Atkelar/XMasOrnament/MakingOf/IMG_20161218_160939.jpg

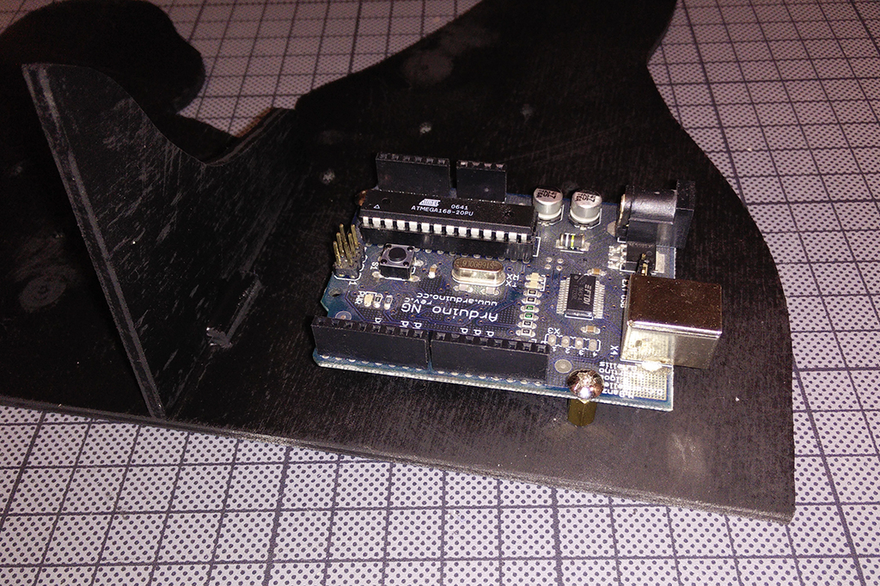
MakingOf/IMG_20161218_160939.jpg
