Atkelar/XMasOrnament/MakingOf/IMG_20161218_172324.jpg

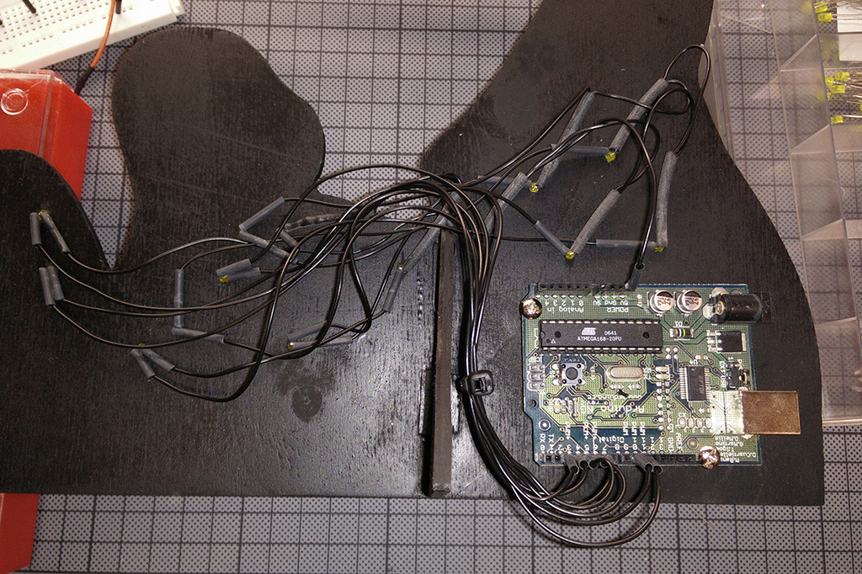
MakingOf/IMG_20161218_172324.jpg
