Atkelar/XMasOrnament/Artwork/CutoutTemplate-1.pdf

## Arduino (NG)

mount on the back.

## Drill for spacer

## threads or screws

Stand

back of the base board.

Glue this end to the

Base board: Cut at outlines, sand and drill the
marked holes for your LEDs (3mm or 5mm)

Glue the stand in this area on the back,

make sure that the lower edges are flush.
