Atkelar/XMasOrnament/Artwork/CutoutTemplate-2.pdf

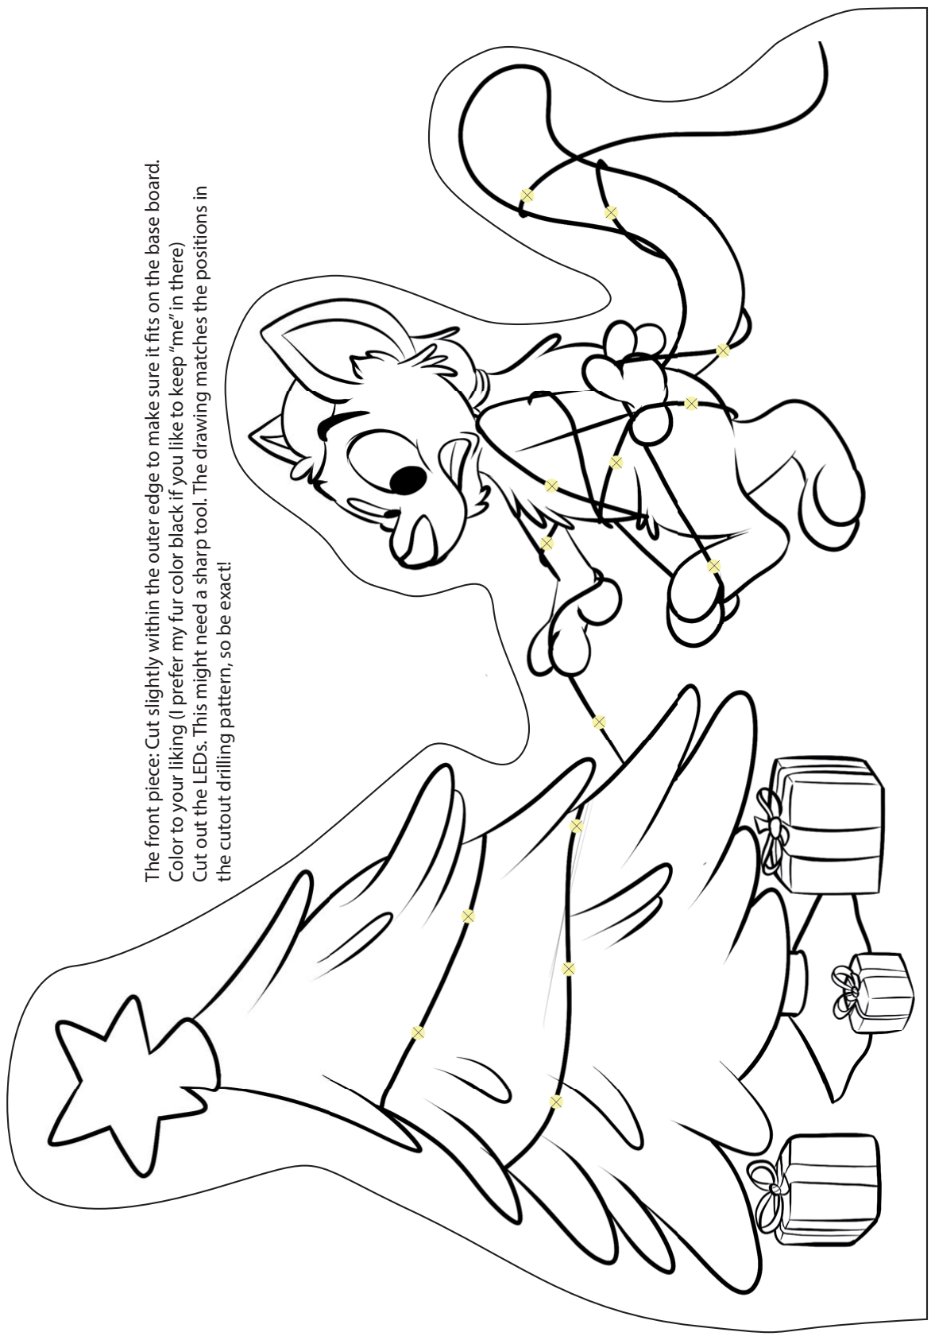
[picture p3: page 1]

The front piece: Cut slightly within the outer edge to make sure it fits on the base board.

Color to your liking (I prefer my fur color black if you like to keep “me” in there)

Cut out the LEDs. This might need a sharp tool. The drawing matches the positions in

the cutout drilling pattern, so be exact!
