Atkelar/XMasOrnament/Schematic.pdf

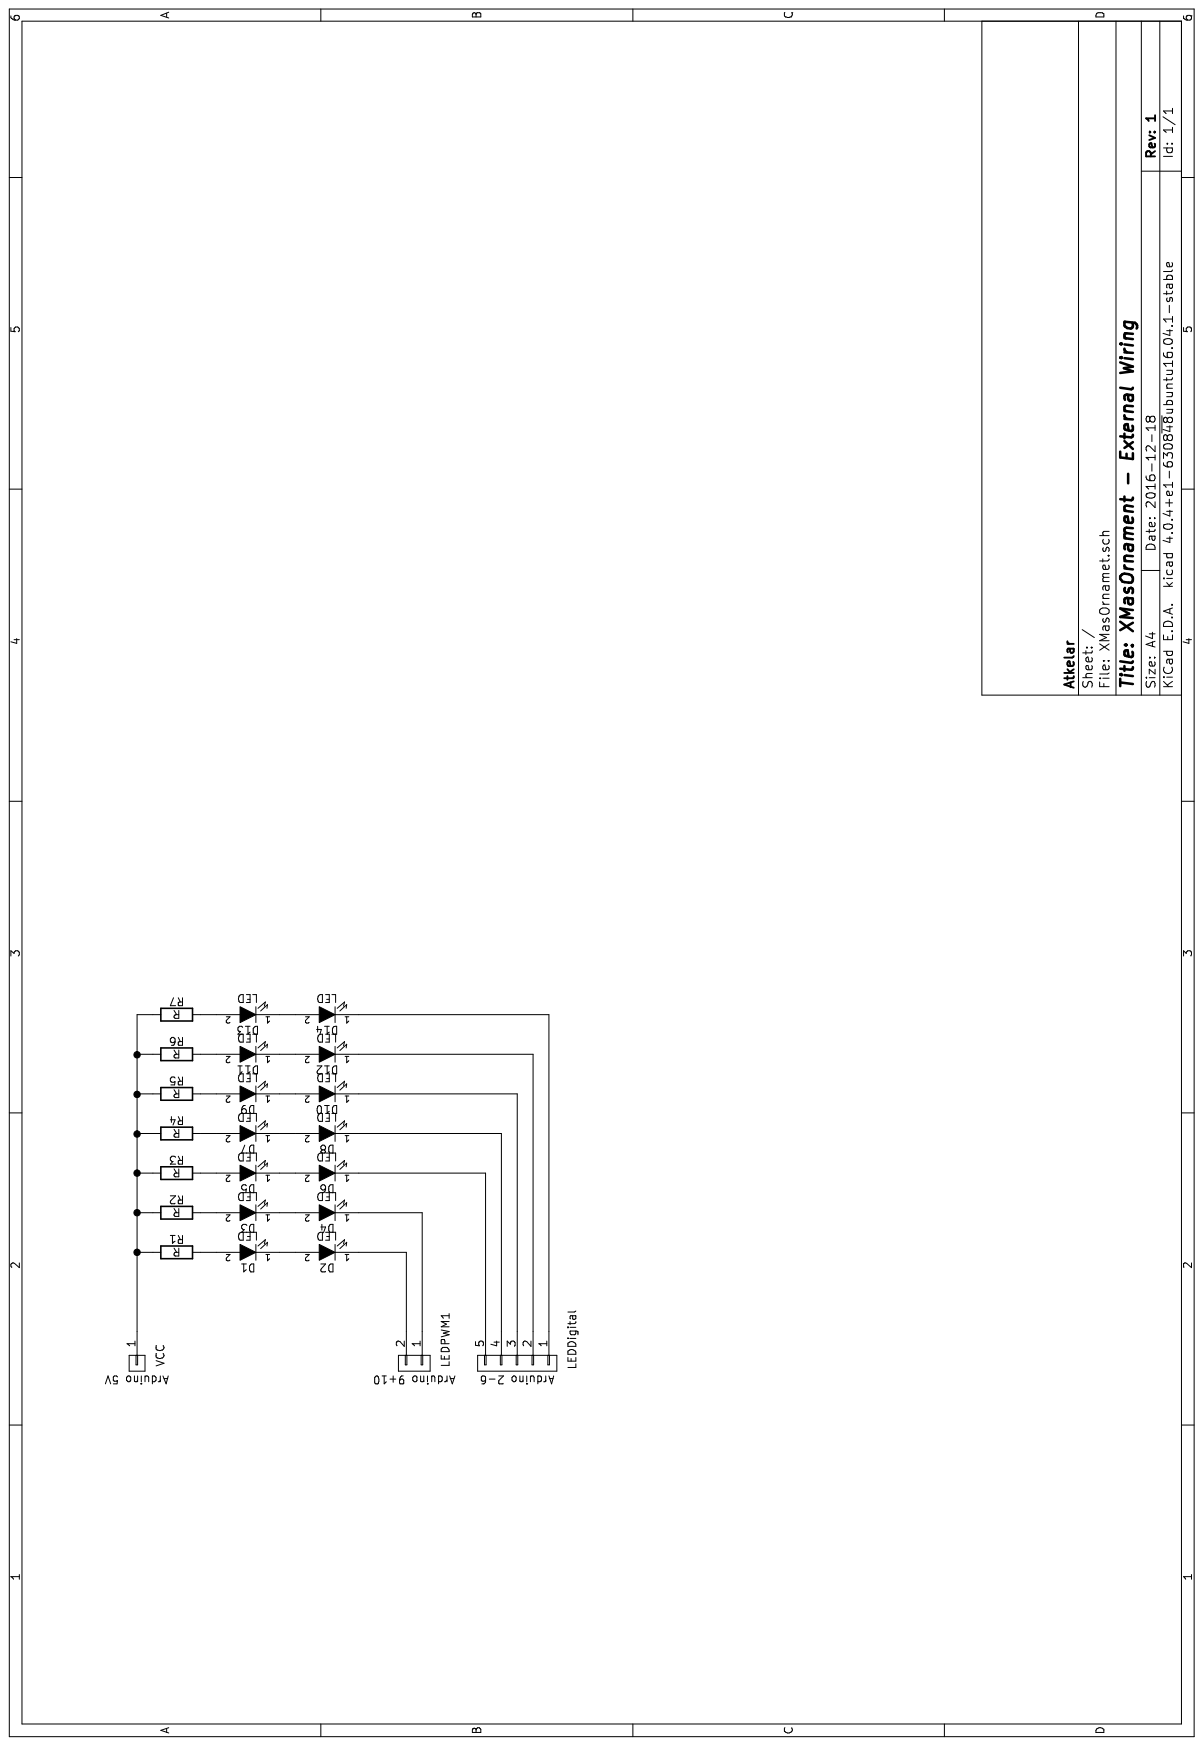
[picture p4: page 1]
