Atkelar/XMasOrnament/MakingOf/IMG_20161218_144124.jpg

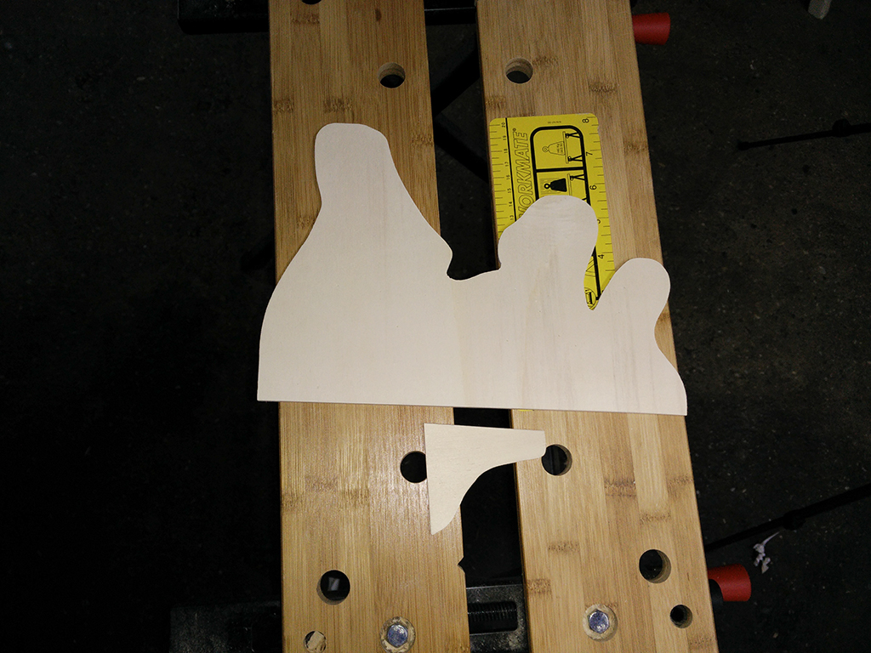
MakingOf/IMG_20161218_144124.jpg
