Atkelar/XMasOrnament/MakingOf/IMG_20161218_160345.jpg

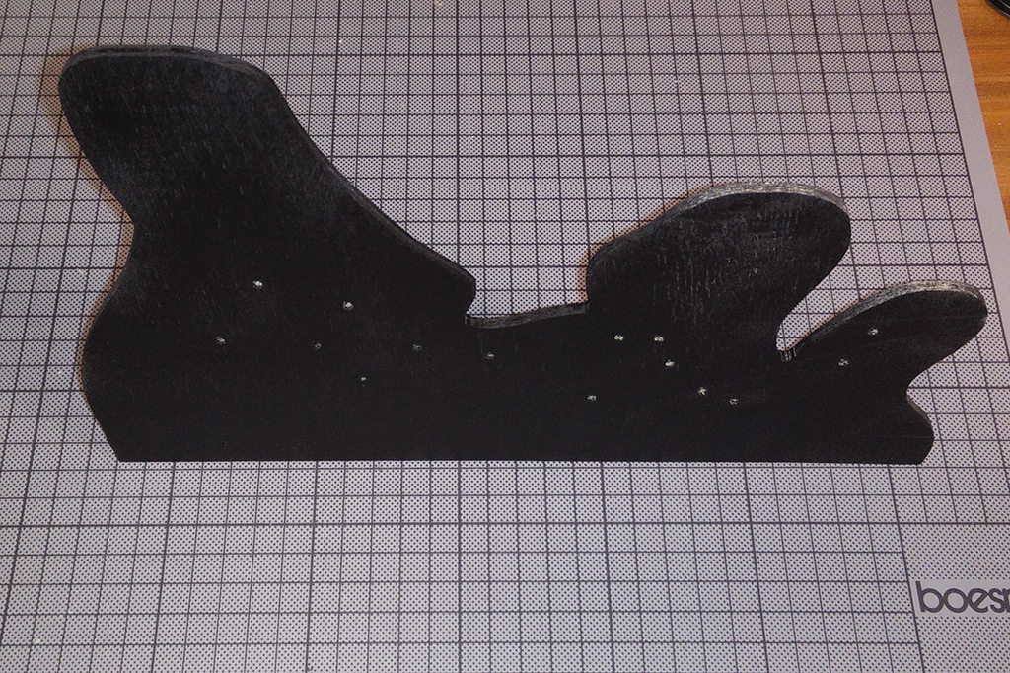
MakingOf/IMG_20161218_160345.jpg
