Atkelar/XMasOrnament/MakingOf/IMG_20161218_160358.jpg

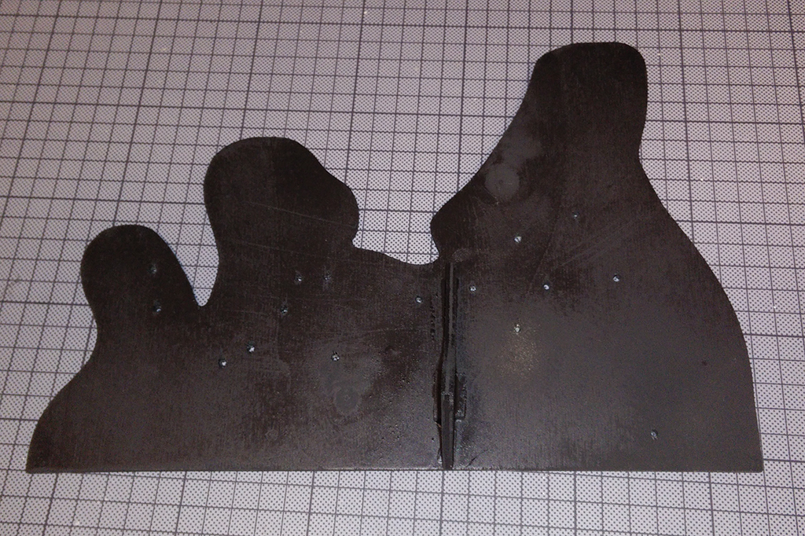
MakingOf/IMG_20161218_160358.jpg
