Atkelar/XMasOrnament/MakingOf/IMG_20161218_160459.jpg

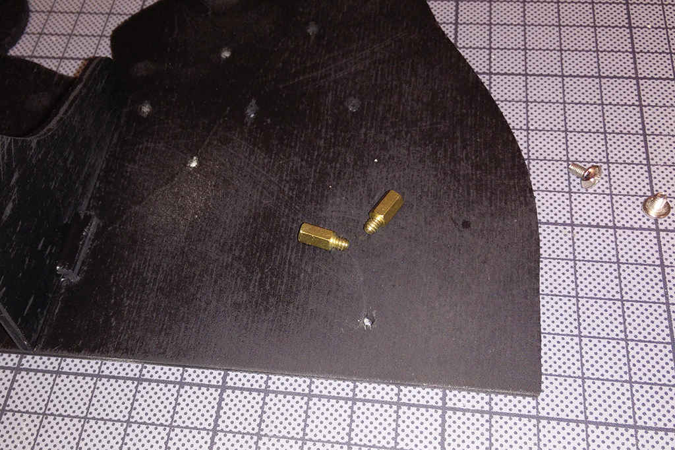
MakingOf/IMG_20161218_160459.jpg
