Atkelar/XMasOrnament/MakingOf/IMG_20161218_162143.jpg

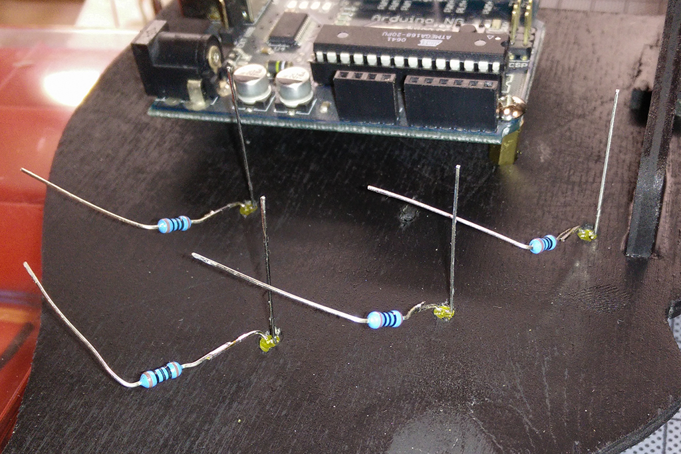
MakingOf/IMG_20161218_162143.jpg
