Atkelar/XMasOrnament/MakingOf/IMG_20161218_164948.jpg

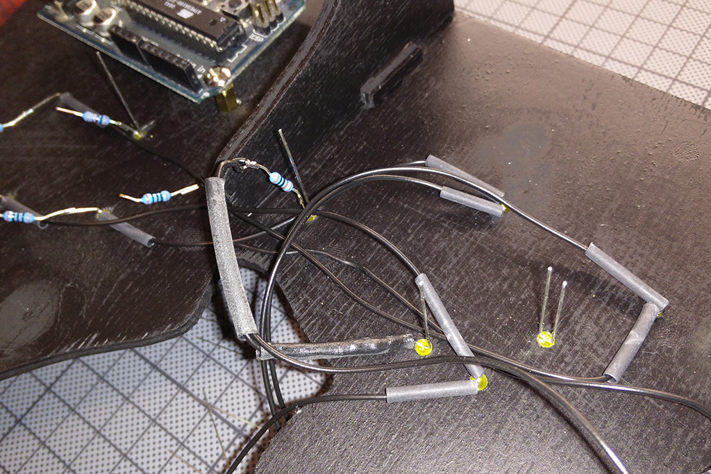
MakingOf/IMG_20161218_164948.jpg
