Atkelar/XMasOrnament/MakingOf/IMG_20161218_210559.jpg

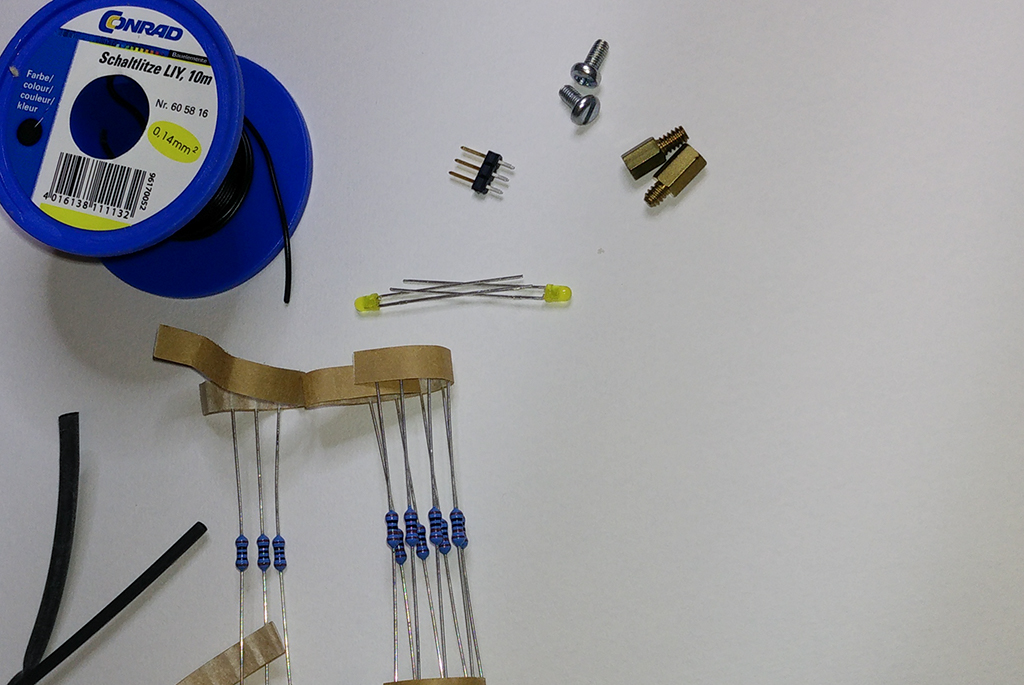
MakingOf/IMG_20161218_210559.jpg
