Atkelar/XMasOrnament/Software/AtkelarXMas.ino

/*

  Atkelar's Christmas Entanglement

  Copyright 2016 by Atkelar

  License: Apache License, Version 2.0

*/

#include "avr/pgmspace.h"
// We need a tad bit more space for the blink-pattern table so 
// we use the program space library and read back the data on-the-go.

// The LED port defaults are: 9 and 10 for PWM output, 2 to 6 for digital.
// The defaults keep pin 0 and 1 free to have 
// debugging TX/RX available if needed.

#define ledPWM1 9
#define ledPWM2 10

#define led0 2
#define led1 3
#define led2 4
#define led3 5
#define led4 6

// The number of steps in the array. Could be calculated by length-of-data / 8.
#define STEPS 165

// The actual light info. To keep the loop simple, we use one byte per pin
// Version 2 would benefit from a structure with bits for digital outputs
// compressed into bit pattern. That way we could *maybe* get away without
// the progmem library. But the pattern generator would be more complicated.
// Pattern data is: 5 digital ports followed by 2 analog ports followed by
// the delay value. The actual loop delay might be slightly larger because
// of all the reading/writing overhead but should be neglectable in MHz clocks.
const byte data[] PROGMEM = {
  LOW, HIGH, HIGH, HIGH, HIGH, 191, 102, 10,
  LOW, HIGH, HIGH, HIGH, HIGH, 179, 102, 10,
  LOW, HIGH, HIGH, HIGH, HIGH, 166, 102, 10,
  LOW, HIGH, HIGH, HIGH, HIGH, 153, 102, 10,
  LOW, HIGH, HIGH, HIGH, HIGH, 141, 102, 10,
  HIGH, HIGH, HIGH, HIGH, HIGH, 128, 102, 50,
  LOW, HIGH, HIGH, HIGH, HIGH, 128, 102, 20,
  LOW, HIGH, HIGH, HIGH, HIGH, 145, 102, 10,
  LOW, HIGH, HIGH, HIGH, HIGH, 162, 102, 10,
  LOW, HIGH, HIGH, HIGH, HIGH, 179, 102, 10,
  HIGH, HIGH, HIGH, HIGH, HIGH, 196, 94, 10,
  HIGH, HIGH, HIGH, HIGH, HIGH, 213, 85, 10,
  HIGH, HIGH, HIGH, HIGH, HIGH, 230, 76, 10,
  HIGH, HIGH, HIGH, HIGH, HIGH, 230, 68, 10,
  HIGH, HIGH, HIGH, HIGH, HIGH, 230, 60, 10,
  LOW, HIGH, HIGH, HIGH, HIGH, 230, 51, 10,
  LOW, HIGH, HIGH, HIGH, HIGH, 230, 42, 10,
  LOW, HIGH, HIGH, HIGH, HIGH, 230, 34, 10,
  LOW, HIGH, HIGH, HIGH, HIGH, 230, 26, 10,
  LOW, LOW, HIGH, HIGH, HIGH, 230, 17, 10,
  HIGH, LOW, HIGH, HIGH, HIGH, 230, 8, 10,
  HIGH, LOW, HIGH, HIGH, HIGH, 230, 0, 40,
  HIGH, LOW, LOW, HIGH, HIGH, 230, 0, 60,
  HIGH, LOW, LOW, LOW, HIGH, 196, 0, 10,
  HIGH, LOW, LOW, LOW, HIGH, 162, 0, 10,
  HIGH, LOW, LOW, LOW, HIGH, 128, 0, 10,
  HIGH, LOW, LOW, LOW, HIGH, 94, 0, 10,
  LOW, LOW, LOW, LOW, HIGH, 60, 0, 10,
  LOW, LOW, LOW, LOW, HIGH, 26, 0, 40,
  LOW, LOW, LOW, LOW, HIGH, 26, 2, 10,
  LOW, LOW, LOW, LOW, HIGH, 26, 4, 10,
  LOW, LOW, LOW, LOW, HIGH, 26, 6, 10,
  LOW, HIGH, LOW, LOW, HIGH, 26, 9, 10,
  LOW, HIGH, LOW, LOW, HIGH, 26, 11, 10,
  LOW, HIGH, LOW, LOW, HIGH, 26, 13, 10,
  LOW, HIGH, LOW, LOW, HIGH, 30, 15, 10,
  LOW, HIGH, LOW, LOW, HIGH, 34, 17, 10,
  LOW, HIGH, LOW, LOW, HIGH, 38, 20, 10,
  LOW, HIGH, LOW, LOW, LOW, 43, 22, 10,
  HIGH, HIGH, LOW, LOW, LOW, 47, 24, 10,
  HIGH, HIGH, LOW, LOW, LOW, 51, 26, 40,
  LOW, HIGH, LOW, LOW, LOW, 51, 26, 30,
  LOW, HIGH, LOW, HIGH, LOW, 85, 26, 10,
  LOW, HIGH, LOW, HIGH, LOW, 119, 26, 10,
  LOW, HIGH, LOW, HIGH, LOW, 153, 26, 10,
  LOW, HIGH, LOW, HIGH, LOW, 187, 26, 10,
  LOW, HIGH, LOW, HIGH, LOW, 221, 26, 10,
  LOW, HIGH, LOW, HIGH, LOW, 255, 26, 40,
  LOW, LOW, HIGH, HIGH, LOW, 255, 26, 30,
  HIGH, LOW, HIGH, HIGH, LOW, 225, 26, 10,
  HIGH, LOW, HIGH, HIGH, LOW, 195, 26, 10,
  HIGH, LOW, HIGH, HIGH, LOW, 165, 26, 10,
  HIGH, LOW, HIGH, HIGH, LOW, 136, 26, 10,
  HIGH, LOW, HIGH, HIGH, LOW, 106, 26, 10,
  LOW, LOW, HIGH, HIGH, LOW, 76, 26, 40,
  LOW, LOW, HIGH, HIGH, LOW, 76, 41, 10,
  LOW, LOW, HIGH, HIGH, LOW, 76, 56, 10,
  LOW, LOW, HIGH, HIGH, LOW, 76, 70, 10,
  LOW, LOW, HIGH, HIGH, LOW, 93, 85, 10,
  LOW, LOW, HIGH, HIGH, LOW, 110, 100, 10,
  LOW, LOW, HIGH, HIGH, LOW, 127, 115, 10,
  LOW, LOW, HIGH, LOW, LOW, 144, 130, 10,
  LOW, LOW, HIGH, LOW, LOW, 161, 145, 10,
  LOW, LOW, HIGH, LOW, LOW, 178, 160, 10,
  LOW, HIGH, HIGH, LOW, LOW, 178, 174, 10,
  LOW, HIGH, HIGH, LOW, LOW, 178, 189, 10,
  HIGH, HIGH, HIGH, LOW, LOW, 178, 204, 10,
  HIGH, HIGH, LOW, LOW, LOW, 157, 204, 10,
  HIGH, HIGH, LOW, LOW, LOW, 136, 204, 10,
  HIGH, HIGH, LOW, LOW, LOW, 115, 204, 10,
  HIGH, HIGH, LOW, LOW, HIGH, 93, 204, 10,
  HIGH, HIGH, LOW, LOW, HIGH, 72, 204, 10,
  HIGH, HIGH, LOW, LOW, HIGH, 51, 204, 70,
  HIGH, HIGH, LOW, LOW, HIGH, 64, 204, 10,
  HIGH, HIGH, LOW, LOW, HIGH, 77, 204, 10,
  LOW, HIGH, LOW, LOW, HIGH, 90, 204, 10,
  LOW, HIGH, LOW, LOW, HIGH, 102, 204, 10,
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
}

void loop() {

  // start the loop by showing the current index:
  int offset = loopIndex * 8;  // Current offset into the data array.

  // read and advance offset, the temp variable 'x' eases debugging
  int x = pgm_read_byte_near(data + offset++);
  digitalWrite(led0, x);

  x = pgm_read_byte_near(data + offset++);
  digitalWrite(led1, x);
  x = pgm_read_byte_near(data + offset++);
  digitalWrite(led2, x);
  x = pgm_read_byte_near(data + offset++);
  digitalWrite(led3, x);
  x = pgm_read_byte_near(data + offset++);
  digitalWrite(led4, x);

  x = pgm_read_byte_near(data + offset++);
  analogWrite(ledPWM1, x);
  x = pgm_read_byte_near(data + offset++);
  analogWrite(ledPWM2, x);

  x = pgm_read_byte_near(data + offset++);
  delay(x);

  // Step up and loop around if we are beyond our realm.
  loopIndex++;
  if (loopIndex >= STEPS)
    loopIndex = 0;
}
