Atkelar/XMasOrnament/(commit log)

2016-12-18 Initialized repository with basic info and current working source code.
2016-12-18 Updated building instructions - should be a clean version 1...
    [XMasOrnamet.kicad_pcb, XMasOrnamet.sch]
